panyixiao/XH_CAD/(commit log)

2022-12-01 feat: 在Ubuntu 20.04 以及 FreeCAD 0.20 版本上编译完成
2022-12-07 feat: RobotWorkbench 可以正常运行，但是ComboView在启动时无法正常加载
2022-12-07 feat: ComboView 显示正常
2023-02-23 feat: 删除关于构型的判断，让ik运行更流畅
2023-03-10 File: add Model Database
    [0603_SMD.stp, 0805_SMD.stp, 1206_SMD.stp, 1210_SMD.stp, 1812_SMD.stp, 2225_SMD.stp, 2512_SMD.stp, A0_Landscape_ISO7200.dxf]
2023-03-14 feat: 修复末端示教崩溃的问题
2023-03-22 feat: 工具数据库编辑完成，开始实现工具组装
2023-03-23 feat: PlanningObject mount/dismount ok, Restore From Saved Document has few bugs
    [AppRobot.cpp, AppRobotGui.cpp, CAD_Utility.cpp, CommandModels.cpp, DS_Utility.cpp, DS_Utility.h]
2023-04-08 feat: 完成机器人绑定变位机功能，需要重新设计“外部轴”对象，然后马上开始针对特征轨迹和任务管理的重构
2023-04-21 feat: 目前设备功能正常，准备重构任务管理模块
